dweggg/MagneticLevitation/README.md

# MagneticLevitation
My take on one of those active magnetic levitation projects.
