dweggg/MagneticLevitation/hw/scripts/outputs/maglev_root_locus.png

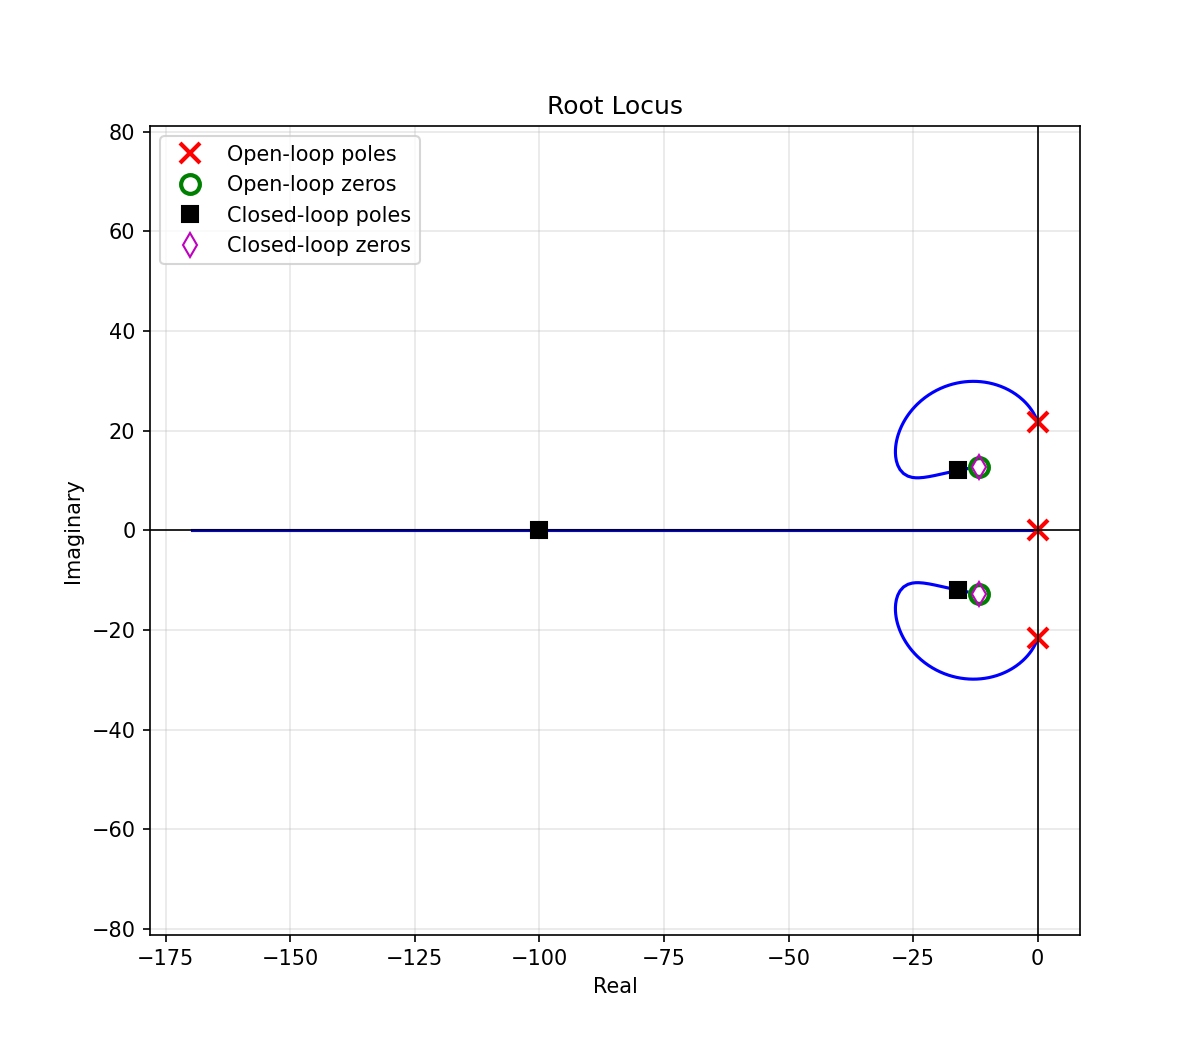
hw/scripts/outputs/maglev_root_locus.png
