dweggg/MagneticLevitation/hw/scripts/outputs/maglev_sim_animation.gif

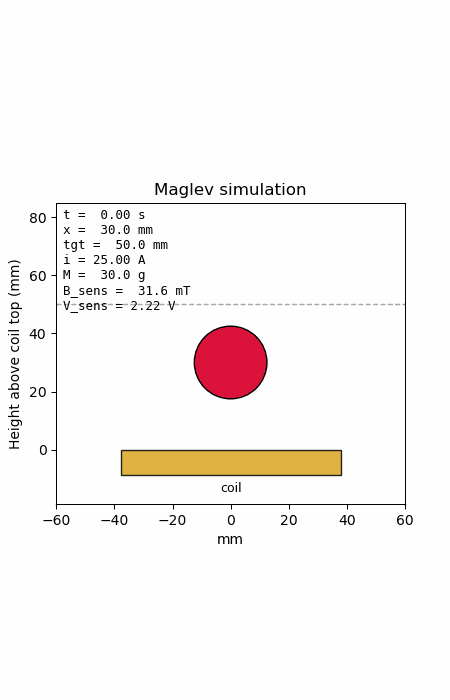
hw/scripts/outputs/maglev_sim_animation.gif
