dweggg/MagneticLevitation/hw/scripts/outputs/maglev_sim_plots.png

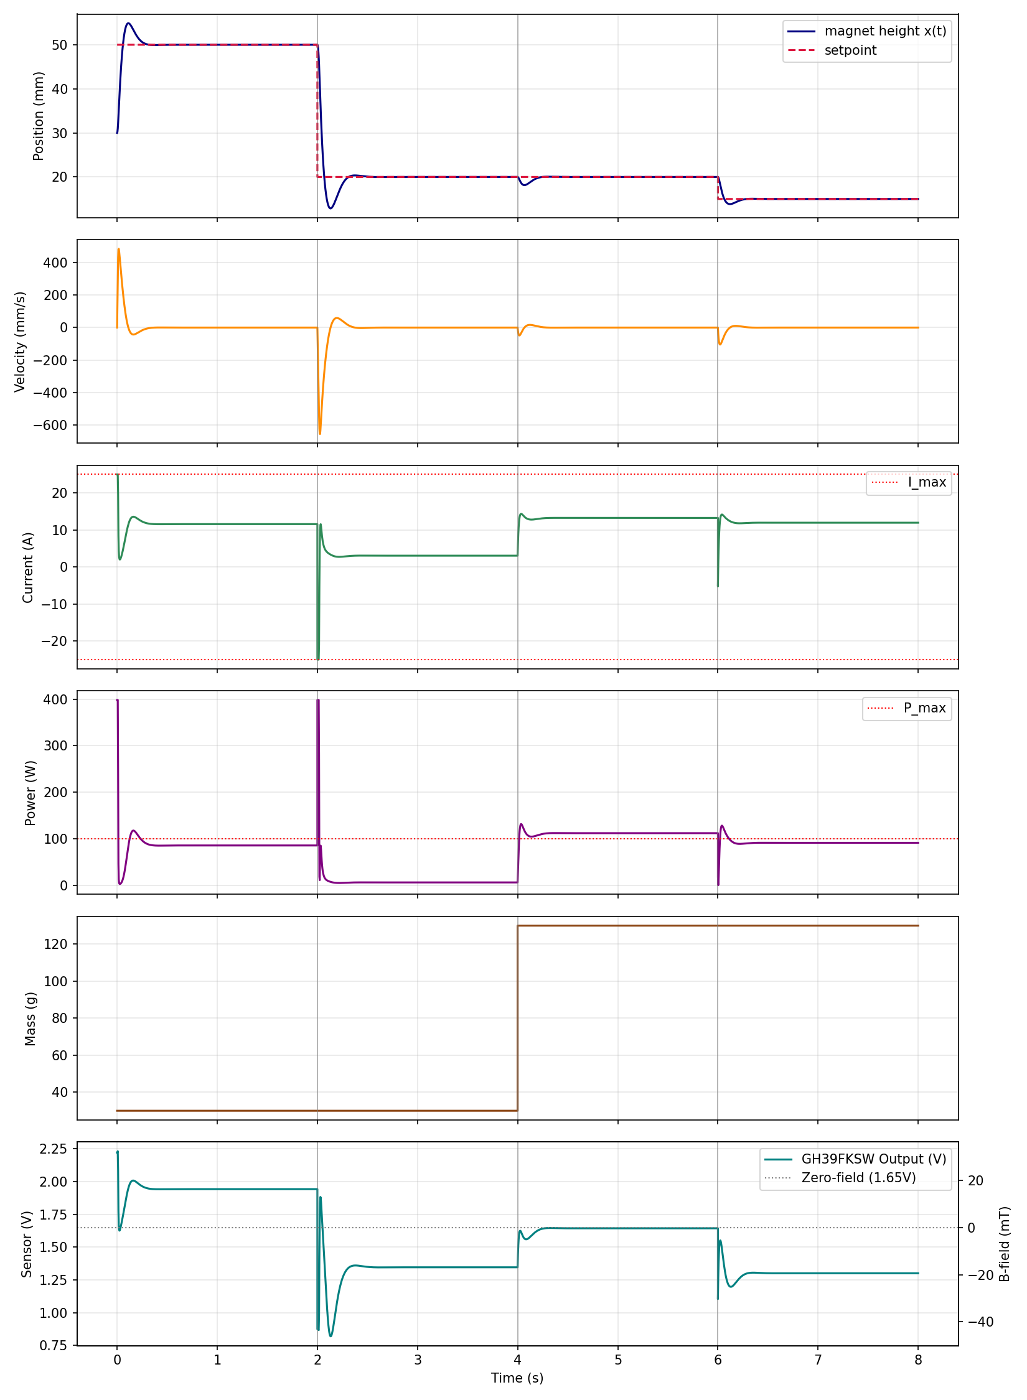
hw/scripts/outputs/maglev_sim_plots.png
