dweggg/MagneticLevitation/hw/MagneticLevitation.pdf

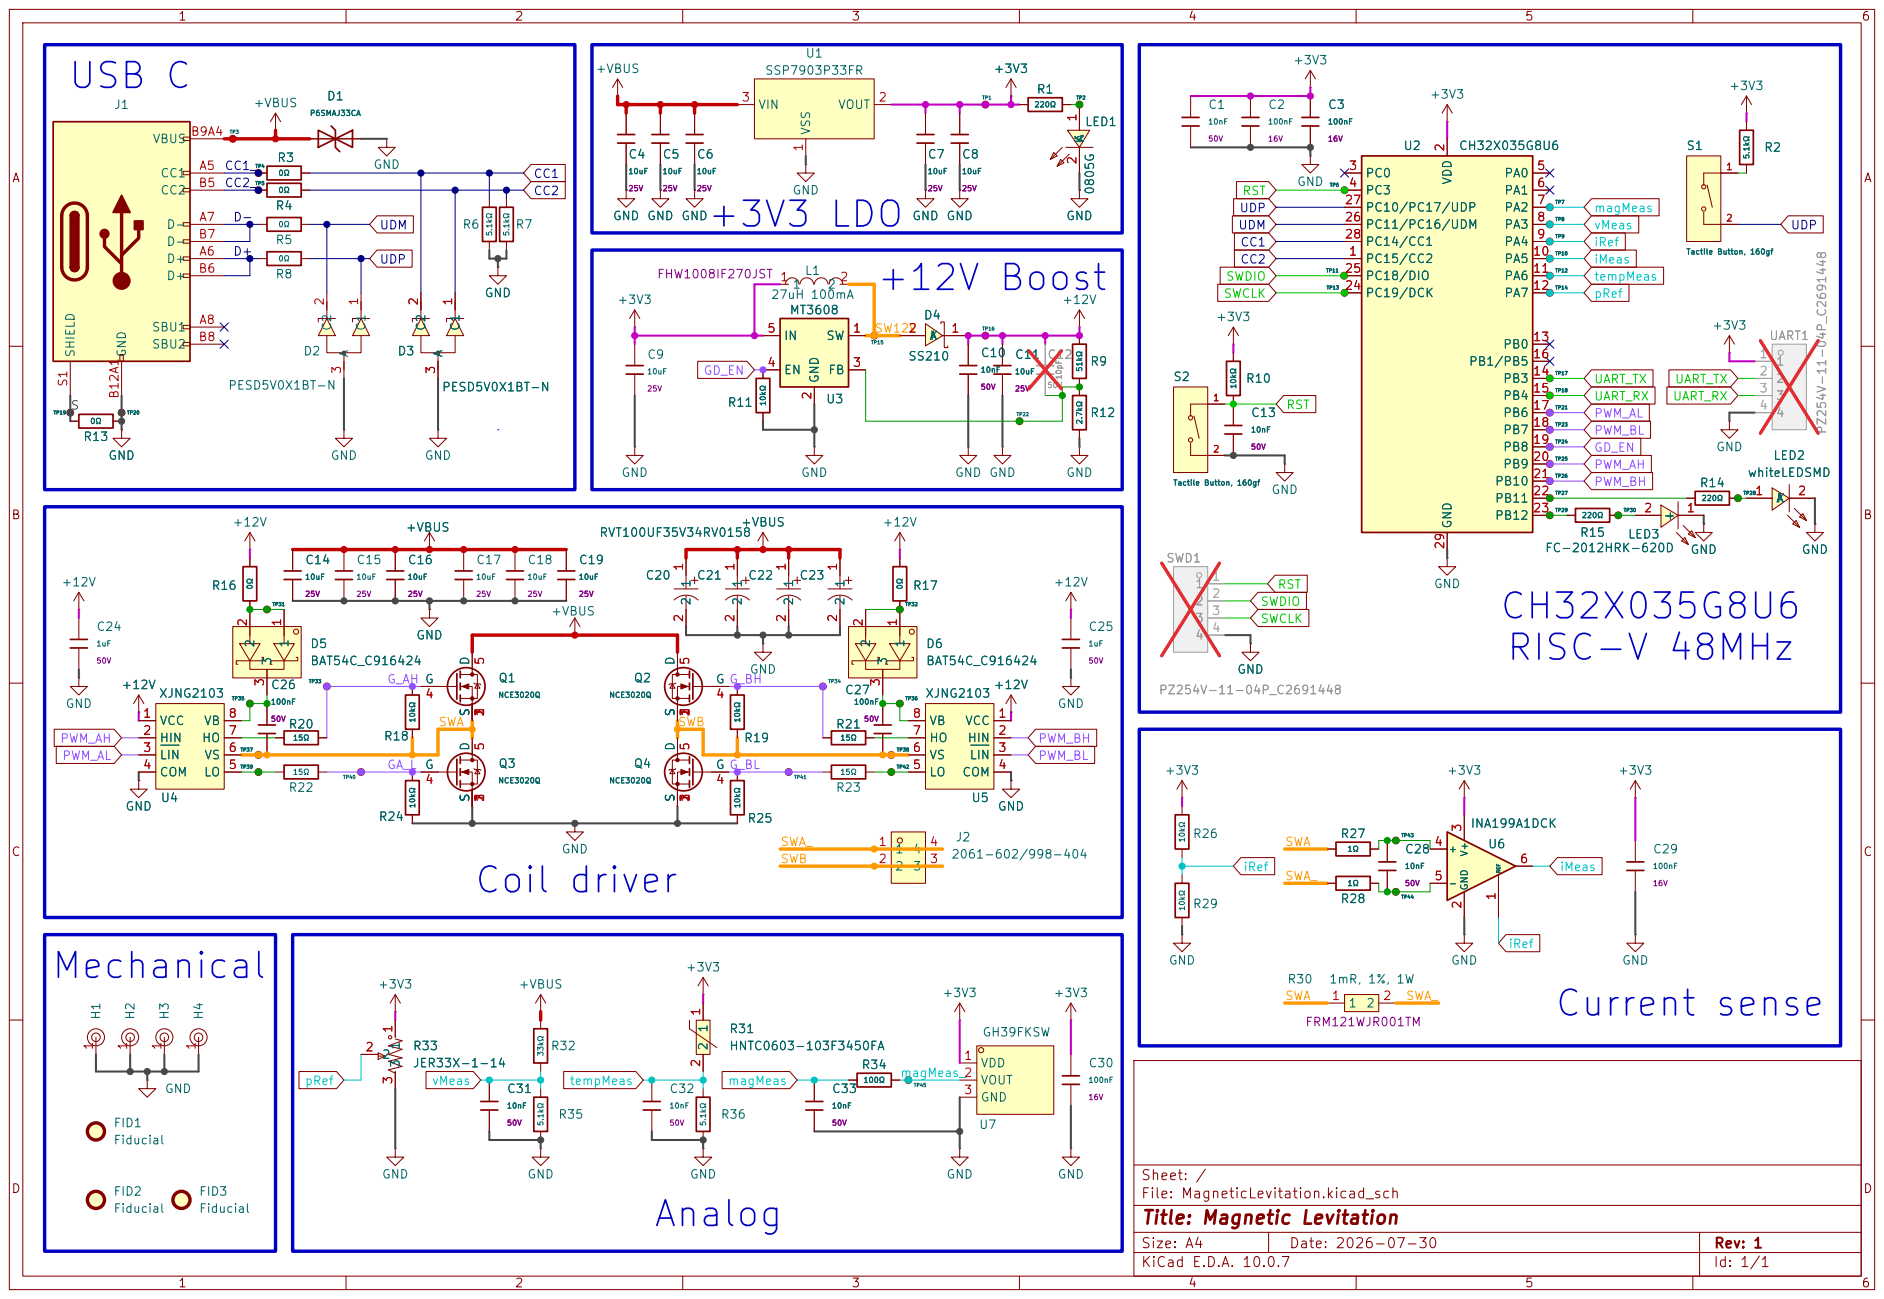
[picture p4: page 1]

10uF 25V GND | 220Ω

2 PC0 3 PC3 4 PA0 5 PA1 6 PA2 7 PA3 8 PA4 9 PA5 10 PA6 11 PA7 12 PB0 13 PB3 14 PB4 15 PB6 17 PB7 18 PB8 19 PB9 20 PB10 21 PB11 22 PB12 23 PC19/DCK 24 PC18/DIO 25 PC11/PC16/UDM 26 PC10/PC17/UDP 27 PC14/CC1 28 GND 29

Size: A4 | Rev: 1
KiCad E.D.A. 10.0.7 | Id: 1/1
