dweggg/MagneticLevitation/hw/spice/bootstrap.asc

C1: cap; 220n
D1: schottky; BAT54CHY
D2: schottky; BAT54CHY
L1: ind; 3m
M1: nmos; Si7998DP_1
M2: nmos; Si7998DP_1
R1: res; 10k
R2: res; 10
R3: res; 10k
R4: res; 10
R5: res; 2
U1: dgd2304
V1: voltage; 12
V2: voltage; 20
V3: voltage; PWL file=pwm_high.pwl
V4: voltage; PWL file=pwm_low.pwl
Named nets: 12V, 0, VBUS, SW
.tran 10m
