dweggg/MagneticLevitation/hw/MagneticLevitation.kicad_pcb

## KiCad design hw/MagneticLevitation.kicad_pcb (2026-08-08)

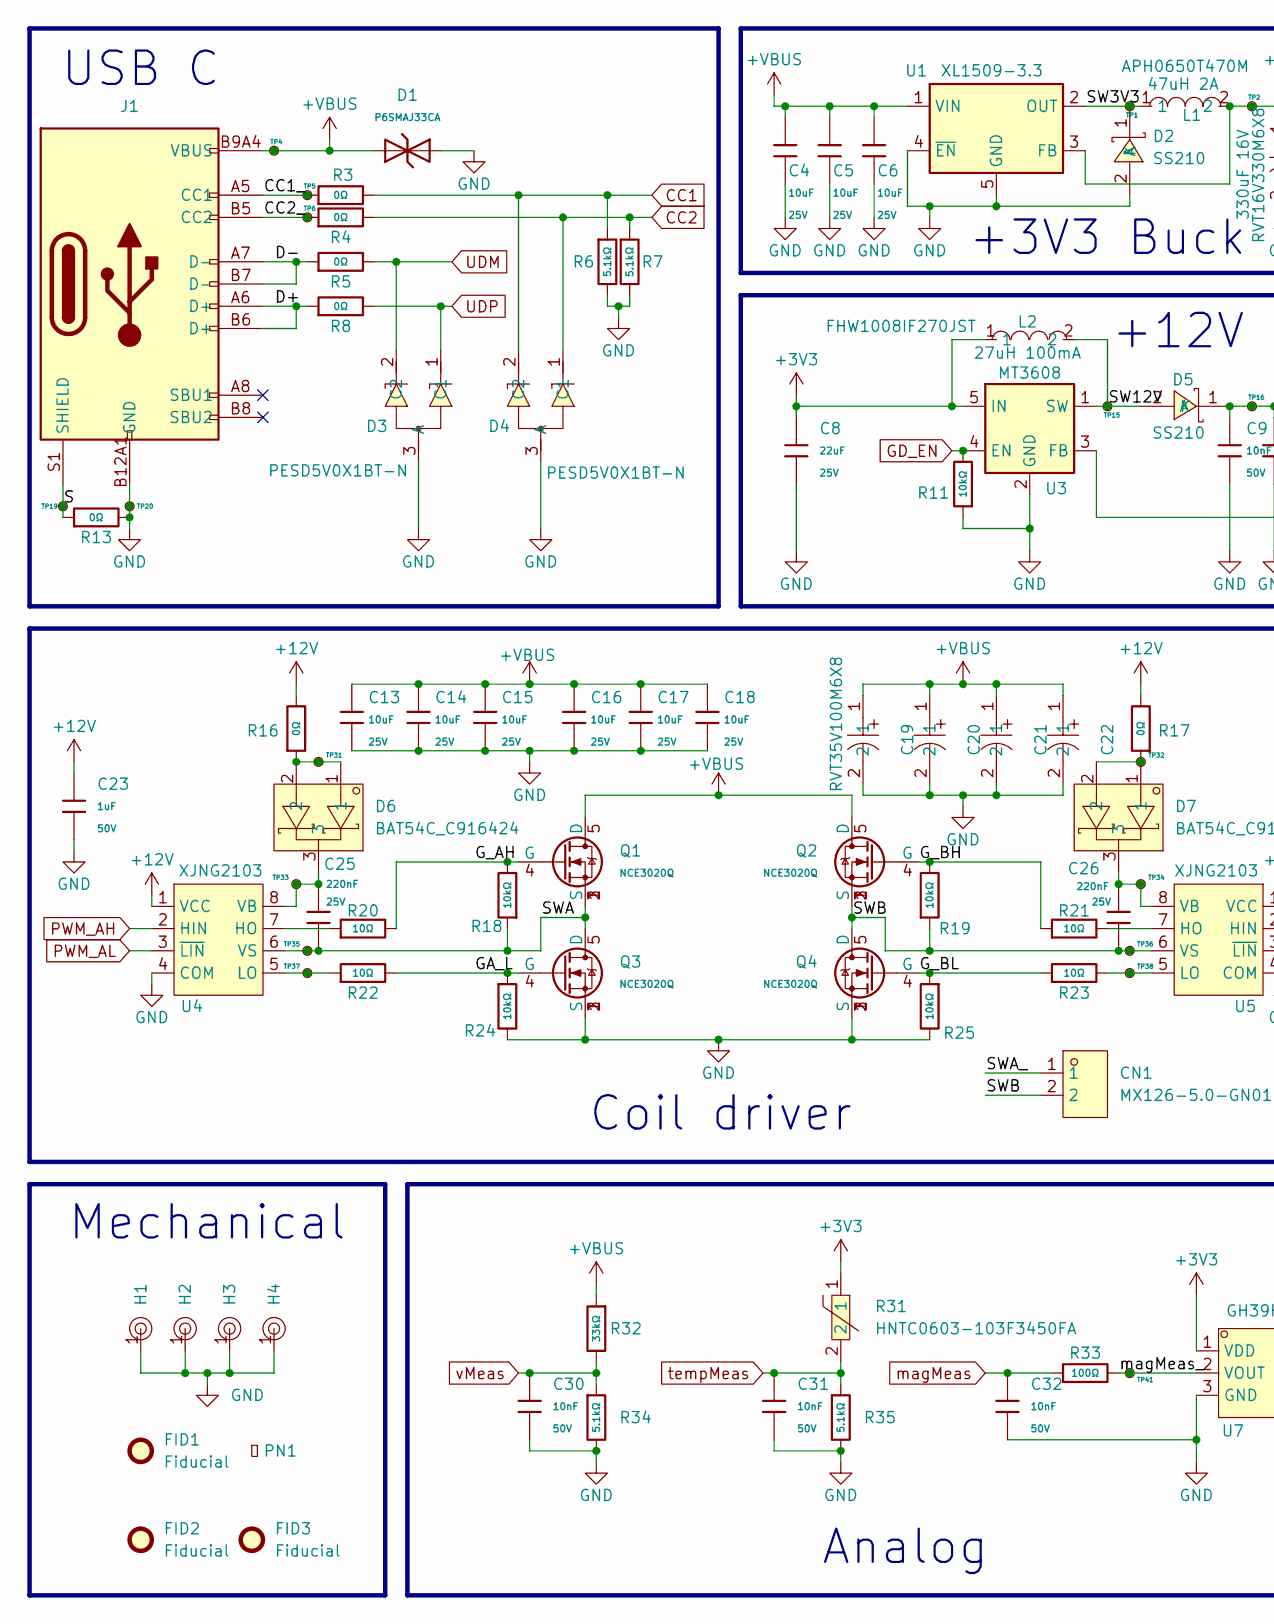
[picture p5: schematic MagneticLevitation.kicad_sch, Magnetic Levitation, part in row 1, column 1]

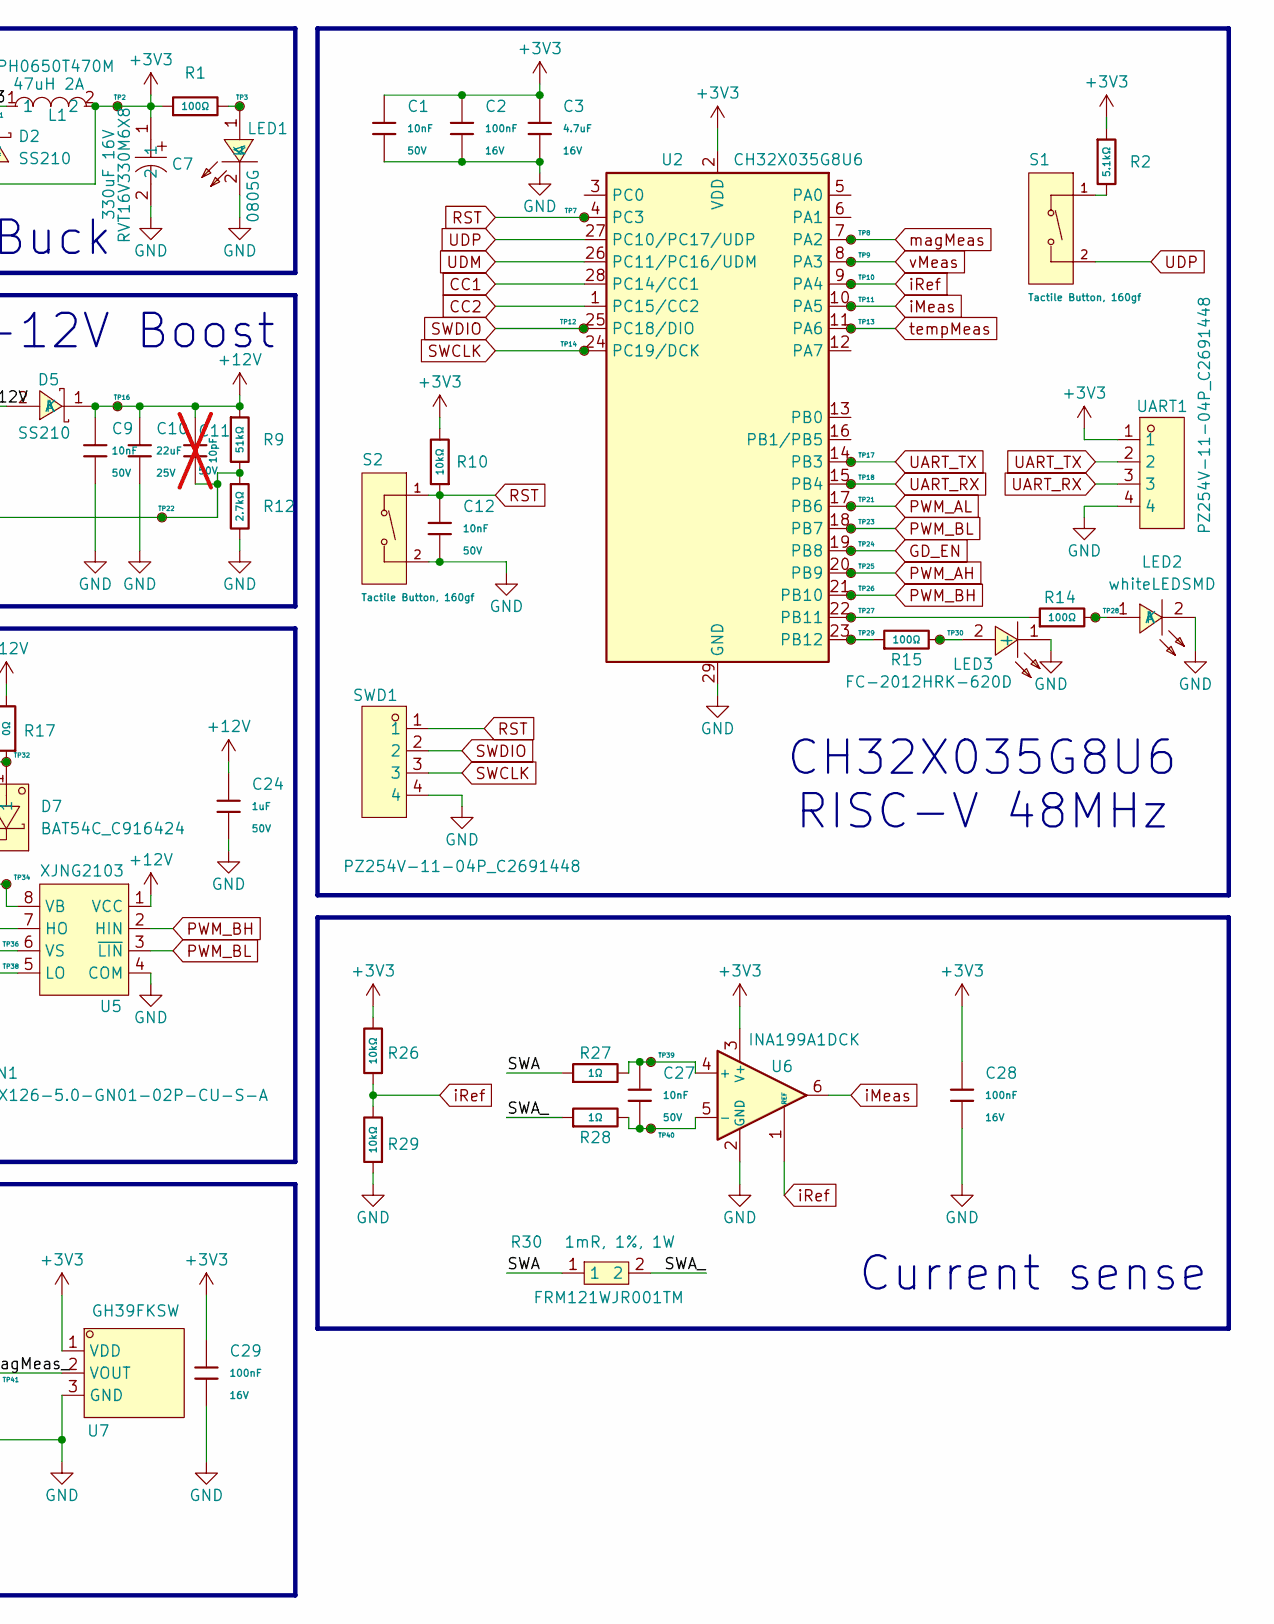
[picture p6: schematic MagneticLevitation.kicad_sch, Magnetic Levitation, part in row 1, column 2]

Parts:
C1, C9, C27: 10nF; C_0402; Voltage Rated 50V; Tolerance ±10%; Part CL05B103KB5NNNC; LCSC C15195
C2, C28, C29: 100nF; C_0402; Voltage Rated 16V; Tolerance ±10%; Part CL05B104KO5NNNC; LCSC C1525
C3: 4.7uF; C_0603; Voltage Rated 16V; Tolerance ±10%; Part CL10A475KO8NNNC; LCSC C19666
C4, C5, C6, C13, C14, C15, C16, C17, C18: 10uF; C_0805; Voltage Rated 25V; Tolerance ±10%; Part CL21A106KAYNNNE; LCSC C15850
C7: 330uF 16V; CAP-SMD_BD6.3-L6.6-W6.6-LS7.2-FD_3; MPN RVT16V330M6X8; LCSC Part C47023104
C8, C10: 22uF; C_1206; Voltage Rated 25V; Tolerance ±10%; Part CL31A226KAHNNNE; LCSC C12891
C11: 10pF; C_0603; Voltage Rated 50V; Tolerance ±5%; Part CL10C100JB8NNNC; LCSC C1634; not fitted
C12, C30, C31, C32: 10nF; C_0603; Voltage Rated 50V; Tolerance ±10%; Part 0603B103K500NT; LCSC C57112
C19, C20, C21, C22: RVT35V100M6X8; CAP-SMD_BD6.3-L6.6-W6.6-FD-1; MPN RVT35V100M6X8; LCSC Part C47023113
C23, C24: 1uF; C_0805; Voltage Rated 50V; Tolerance ±10%; Part CL21B105KBFNNNE; LCSC C28323
C25, C26: 220nF; C_0603; Voltage Rated 25V; Tolerance ±10%; Part CL10B224KA8NNNC; LCSC C21120
CN1: MX126-5.0-GN01-02P-CU-S-A; CONN-TH_2P-P5.00_MX126-5.0-GN01-02P-CU-S-A; MPN MX126-5.0-02P-GN01-Cu-S-A; LCSC Part C5188434
D1: P6SMAJ33CA; D_DO-214AC(SMA); Breakdown Voltage 36.7V; Part P6SMAJ33CA; LCSC C3019524
D2, D5: SS210; SMA_L4.3-W2.6-LS5.2-RD; MPN SS210; LCSC Part C14996
D3, D4: PESD5V0X1BT-N; SOT-23-3_L2.9-W1.3-P1.90-LS2.4-BR; MPN PESD5V0X1BT-N; LCSC Part C920303
D6, D7: BAT54C_C916424; SOT-23-3_L2.9-W1.3-P1.90-LS2.4-BR; MPN BAT54C; LCSC Part C916424
FID1, FID2, FID3: Fiducial; Fiducial_0.5mm_Mask1.5mm
H1, H2, H3, H4: Hole, 3mm
J1: Connector, USB-TYPE-C-16P; TYPE-C-SMD_HX-TYPE-C-16PIN; LCSC C2927039
L1: 47uH 2A; IND-SMD_L7.0-W6.6_APH0650T3R3M; MPN APH0650T470M; LCSC Part C5349694
L2: 27uH 100mA; IND-SMD_L2.9-W2.8; MPN FHW1008IF270JST; LCSC Part C394070
LED1: 0805G; LED0805-R-RD; MPN KT-0805G; LCSC Part C2297
LED2: whiteLEDSMD; LED0805-R-RD; MPN KT-0805W; LCSC Part C34499
LED3: FC-2012HRK-620D; LED0805-RD; MPN NCD0805R1; LCSC Part C84256
PN1: Part_Num_JLCPCB
Q1, Q2, Q3, Q4: NCE3020Q; NCE3020Q_DFN3.3x3.3-8L; Part NCE3020Q; LCSC C918240
R1, R14, R15, R33: 100Ω; R_0603; Overload Voltage (Max) 75V; Tolerance ±1%; Part 0603WAF1000T5E; LCSC C22775
R2, R34, R35: 5.1kΩ; R_0603; Overload Voltage (Max) 75V; Tolerance ±1%; Part 0603WAF5101T5E; LCSC C23186
R3, R4, R5, R8, R13, R16, R17: 0Ω; R_0402; Overload Voltage (Max) 50V; Tolerance ±1%; Part 0402WGF0000TCE; LCSC C17168
R6, R7: 5.1kΩ; R_0402; Overload Voltage (Max) 50V; Tolerance ±1%; Part 0402WGF5101TCE; LCSC C25905
R9: 51kΩ; R_0603; Overload Voltage (Max) 75V; Tolerance ±1%; Part 0603WAF5102T5E; LCSC C23196
R10, R11, R18, R19, R24, R25, R26, R29: 10kΩ; R_0402; Overload Voltage (Max) 50V; Tolerance ±1%; Part 0402WGF1002TCE; LCSC C25744
R12: 2.7kΩ; R_0603; Overload Voltage (Max) 75V; Tolerance ±1%; Part 0603WAF2701T5E; LCSC C13167
R20, R21, R22, R23: 10Ω; R_0603; Overload Voltage (Max) 75V; Tolerance ±1%; Part 0603WAF100JT5E; LCSC C22859
R27, R28: 1Ω; R_0603; Overload Voltage (Max) 75V; Tolerance ±1%; Part 0603WAF100KT5E; LCSC C22936
R30: 1mR, 1%, 1W; R1206; MPN FRM121WJR001TM; LCSC Part C7419993
R31: HNTC0603-103F3450FA; R0603; MPN HNTC0603-103F3450FA; LCSC Part C49247665
R32: 33kΩ; R_0603; Overload Voltage (Max) 75V; Tolerance ±1%; Part 0603WAF3302T5E; LCSC C4216
S1, S2: Tactile Button, 160gf; SW_TS-1088-AR02016; Voltage Rating (Dc) 12V; Part TS-1088-AR02016; LCSC C720477
SWD1: PZ254V-11-04P_C2691448; HDR-TH_4P-P2.54-V-M; MPN PZ254V-11-04P; LCSC Part C2691448
TP1, TP2, TP3, TP4, TP5, TP6, TP7, TP8, TP9, TP10, TP11, TP12, TP13, TP14, TP15, TP16, TP17, TP18, TP19, TP20, TP21, TP22, TP23, TP24, TP25, TP26, TP27, TP28, TP29, TP30, TP31, TP32, TP33, TP34, TP35, TP36, TP37, TP38, TP39, TP40, TP41: TestPoint_Small; TestPoint_Pad_D1.0mm
U1: XL1509-3.3; SOIC-8_3.9x4.9mm_P1.27mm; LCSC C61063
U2: CH32X035G8U6; WQFN-28-1EP_4x4mm_P0.4mm_EP2.7x2.7mm; LCSC C7437027
U3: MT3608; SOT-23-6; LCSC C84817
U4, U5: XJNG2103; SOIC-8_L5.0-W4.0-P1.27-LS6.0-BL; LCSC C2887735
U6: INA199A1DCK; SOT-363_SC-70-6; LCSC C59135
U7: GH39FKSW; SOT-23-3_L2.9-W1.3-P1.90-LS2.4-BR; MPN GH39FKSW; LCSC Part C266230
UART1: PZ254V-11-04P_C2691448; HDR-TH_4P-P2.54-V-M; MPN PZ254V-11-04P; LCSC Part C2691448

Connections:
+3V3: C1.1, C2.1, C3.1, C7.1, C8.1, C28.1, C29.1, L1.2, L2.1, R1.1, R2.1, R10.2, R26.2, R31.1, TP2.1 (1_1), U1.3 (FB), U2.2 (VDD), U3.5 (IN), U6.3 (V+), U7.1 (VDD), UART1.1
+12V: C9.1, C10.1, C11.1, C23.1, C24.1, D5.1 (K), R9.1, R16.2, R17.2, TP16.1 (1_1), U4.1 (VCC), U5.1 (VCC)
+VBUS: C4.1, C5.1, C6.1, C13.1, C14.1, C15.1, C16.1, C17.1, C18.1, C19.1, C20.1, C21.1, C22.1, D1.1, J1.A9B4 (VBUS), J1.B9A4 (VBUS), Q1.5 (D), Q2.5 (D), R32.1, TP4.1 (1_1), U1.1 (VIN)
/CC1_: J1.A5 (CC1), R3.1, TP5.1 (1_1)
/CC2_: J1.B5 (CC2), R4.1, TP6.1 (1_1)
/D+: J1.A6 (D+), J1.B6 (D+), R8.1
/D-: J1.A7 (D-), J1.B7 (D-), R5.1
/GA_L: Q3.4 (G), R22.2, R24.1
/G_AH: Q1.4 (G), R18.2, R20.2
/G_BH: Q2.4 (G), R19.2, R21.1
/G_BL: Q4.4 (G), R23.1, R25.1
/S: J1.S1 (SHIELD), R13.1, TP19.1 (1_1)
/SW3V3: D2.1 (K), L1.1, TP1.1 (1_1), U1.2 (OUT)
/SW12V: D5.2 (A), L2.2, TP15.1 (1_1), U3.1 (SW)
/SWA: C25.2, Q1.1 (S), Q1.2 (S), Q1.3 (S), Q3.5 (D), R18.1, R27.1, R30.1, TP35.1 (1_1), U4.6 (VS)
/SWA_: CN1.1, R28.1, R30.2
/SWB: C26.2, CN1.2, Q2.1 (S), Q2.2 (S), Q2.3 (S), Q4.5 (D), R19.1, TP36.1 (1_1), U5.6 (VS)
/magMeas_: R33.2, TP41.1 (1_1), U7.2 (VOUT)
CC1: D4.2 (C2), R3.2, R6.1, U2.28 (PC14/CC1)
CC2: D4.1 (C1), R4.2, R7.1, U2.1 (PC15/CC2)
GD_EN: R11.2, TP24.1 (1_1), U2.19 (PB8), U3.4 (EN)
GND: C1.2, C2.2, C3.2, C4.2, C5.2, C6.2, C7.2, C8.2, C9.2, C10.2, C12.2, C13.2, C14.2, C15.2, C16.2, C17.2, C18.2, C19.2, C20.2, C21.2, C22.2, C23.2, C24.2, C28.2, C29.2, C30.2, C31.2, C32.2, D1.2, D2.2 (A), D3.3 (A), D4.3 (A), H1.1, H2.1, H3.1, H4.1, J1.A12B1 (GND), J1.B12A1 (GND), LED1.2 (K), LED2.2 (K), LED3.1 (-), Q3.1 (S), Q3.2 (S), Q3.3 (S), Q4.1 (S), Q4.2 (S), Q4.3 (S), R6.2, R7.2, R11.1, R12.2, R13.2, R24.2, R25.2, R29.1, R34.2, R35.2, S2.2 (B), SWD1.4, TP20.1 (1_1), U1.4 (~EN), U1.5 (GND), U1.6 (GND), U1.7 (GND), U1.8 (GND), U2.29 (GND), U3.2 (GND), U4.4 (COM), U5.4 (COM), U6.2 (GND), U7.3 (GND), UART1.4
unnamed: D6.1, D6.2, R16.1, TP31.1 (1_1)
unnamed: D7.1, D7.2, R17.1, TP32.1 (1_1)
unnamed: LED1.1 (A), R1.2, TP3.1 (1_1)
unnamed: LED2.1 (A), R14.2, TP28.1 (1_1)
unnamed: LED3.2 (+), R15.2, TP30.1 (1_1)
unnamed: R2.2, S1.1 (A)
unnamed: R14.1, TP27.1 (1_1), U2.22 (PB11)
unnamed: R15.1, TP29.1 (1_1), U2.23 (PB12)
unnamed: C11.2, R9.2, R12.1, TP22.1 (1_1), U3.3 (FB)
unnamed: R20.1, U4.7 (HO)
unnamed: R22.1, TP37.1 (1_1), U4.5 (LO)
unnamed: C25.1, D6.3, TP33.1 (1_1), U4.8 (VB)
unnamed: R21.2, U5.7 (HO)
unnamed: R23.2, TP38.1 (1_1), U5.5 (LO)
unnamed: C26.1, D7.3, TP34.1 (1_1), U5.8 (VB)
unnamed: C27.1, R27.2, TP39.1 (1_1), U6.4 (+)
unnamed: C27.2, R28.2, TP40.1 (1_1), U6.5 (-)
PWM_AH: TP25.1 (1_1), U2.20 (PB9), U4.2 (HIN)
PWM_AL: TP21.1 (1_1), U2.17 (PB6), U4.3 (~LIN)
PWM_BH: TP26.1 (1_1), U2.21 (PB10), U5.2 (HIN)
PWM_BL: TP23.1 (1_1), U2.18 (PB7), U5.3 (~LIN)
RST: C12.1, R10.1, S2.1 (A), SWD1.1, TP7.1 (1_1), U2.4 (PC3)
SWCLK: SWD1.3, TP14.1 (1_1), U2.24 (PC19/DCK)
SWDIO: SWD1.2, TP12.1 (1_1), U2.25 (PC18/DIO)
UART_RX: TP18.1 (1_1), U2.15 (PB4), UART1.3
UART_TX: TP17.1 (1_1), U2.14 (PB3), UART1.2
UDM: D3.2 (C2), R5.2, U2.26 (PC11/PC16/UDM)
UDP: D3.1 (C1), R8.2, S1.2 (B), U2.27 (PC10/PC17/UDP)
iMeas: TP11.1 (1_1), U2.10 (PA5), U6.6
iRef: R26.1, R29.2, TP10.1 (1_1), U2.9 (PA4), U6.1 (REF)
magMeas: C32.1, R33.1, TP8.1 (1_1), U2.7 (PA2)
tempMeas: C31.1, R31.2, R35.1, TP13.1 (1_1), U2.11 (PA6)
vMeas: C30.1, R32.2, R34.1, TP9.1 (1_1), U2.8 (PA3)

Notes on the sheet:
+3V3 Buck
Current sense
CH32X035G8U6 RISC-V 48MHz
Coil driver
Mechanical
Analog
+12V Boost
USB C

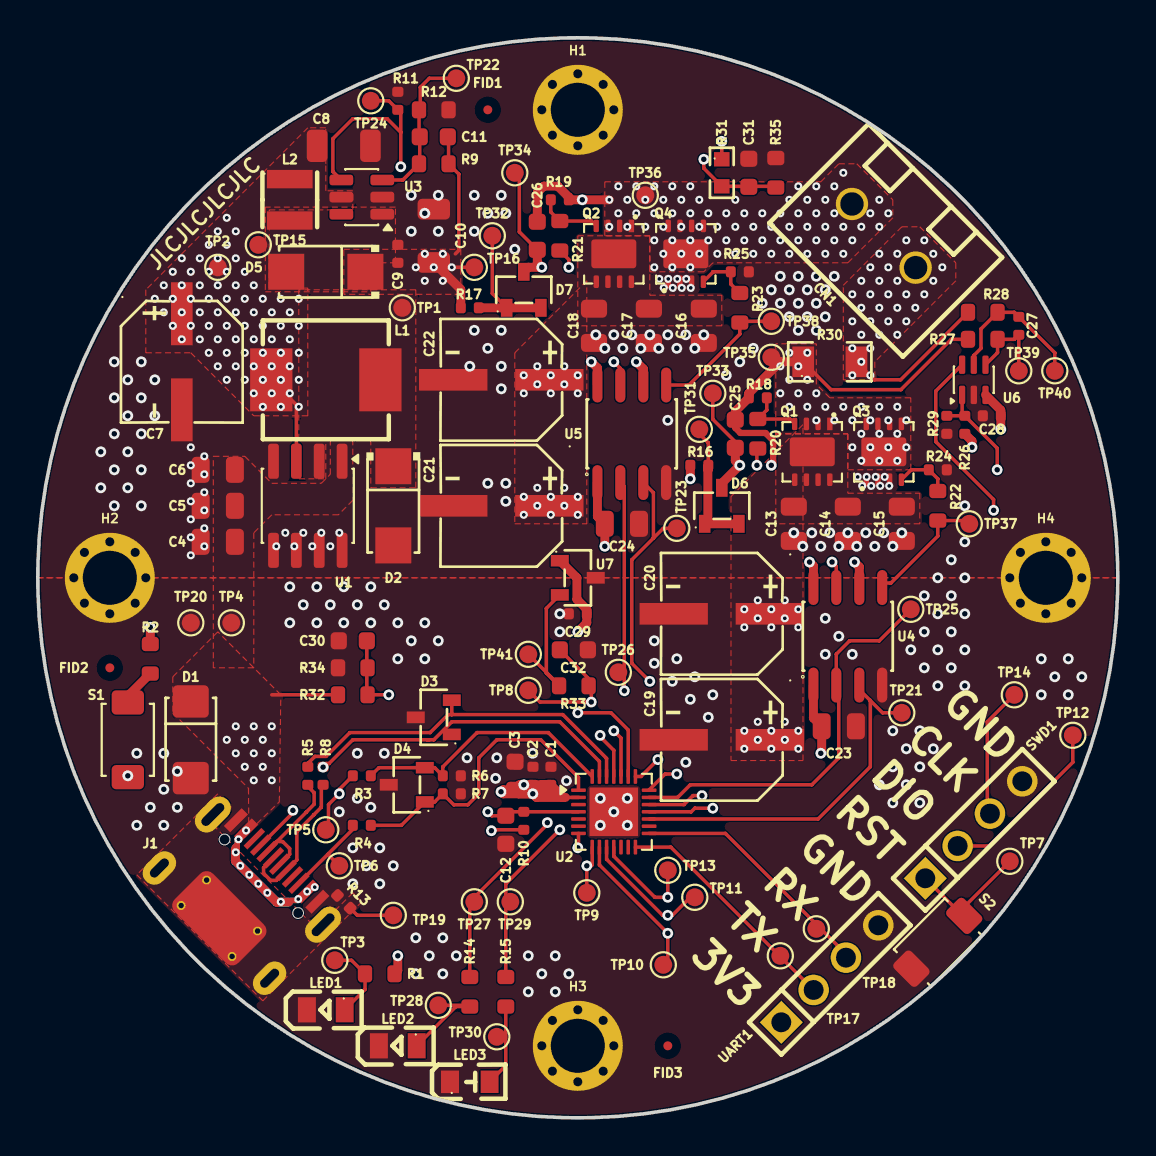
[picture p7: board MagneticLevitation.kicad_pcb from above]

Board: 4 copper layers, 60.0 x 60.0 mm, 145 parts (0 on the bottom side), 55 nets.
