dweggg/MagneticLevitation/fw/app/system/fsm.h

#ifndef FSM_H
#define FSM_H

typedef enum
{
	FSM_INIT,
	FSM_RESET,
	FSM_IDLE,
	FSM_CURRENT_CONTROL,
	FSM_FAULT
} fsm_state_t;

void task_fsm(void);

void init_pins_fsm(void);

fsm_state_t fsm_state(void);
#endif // FSM_H
