dweggg/MagneticLevitation/(commit log)

2026-07-31 initial work sch
    [MagneticLevitation.kicad_pcb, MagneticLevitation.kicad_sch]
2026-08-01 layout 30%
    [MagneticLevitation.kicad_pcb, MagneticLevitation.kicad_sch]
2026-08-02 pcb 99.9999%
    [MagneticLevitation.kicad_pcb, MagneticLevitation.kicad_sch]
2026-08-07 pcb 100%, fw start
    [MagneticLevitation.kicad_pcb, MagneticLevitation.kicad_sch]
2026-08-08 pcb in production!
    [MagneticLevitation.kicad_pcb, MagneticLevitation.kicad_sch]
2026-08-28 pin init function in each module
2026-08-28 not too difficult to set up ADC
2026-08-29 added sw reset bc hw reset doesnt work
    [fsm.c, fsm.h]
2026-08-29 timer setup
2026-08-30 my dummy ass didnt run DRC and now 5 boards are MCU only lol
2026-08-30 start hw design fixes
    [MagneticLevitation.kicad_sch]
2026-08-31 lil rework on dbg bridge and some timer config
    [current_control.c, current_control.h, fsm.c]
2026-08-31 current controller started
2026-08-31 style and use of fix16 funcs
    [control_f16.c, control_f16.h, current_control.c]
2026-09-04 adc start. looking ugly but it works
2026-09-04 fsw, kp, ki wired to comms
2026-09-04 via fix pcb and updated todo's
    [MagneticLevitation.kicad_pcb]
2026-09-04 some progress on rev1
    [MagneticLevitation.kicad_sch]
2026-09-13 we are driving some current already with a reworked rev0 board
    [current_control.c, fsm.c]
2026-09-13 fixed cli bug telemetry, variable names visible
    [cli.py, telemetry.py, transport.py]
2026-09-13 messing around with current controller :)
2026-10-28 ready for factory! but will sit on the board for a few days before ordering
